mikeysklar/flatchord/cad/flatchord-button_thumb.stl

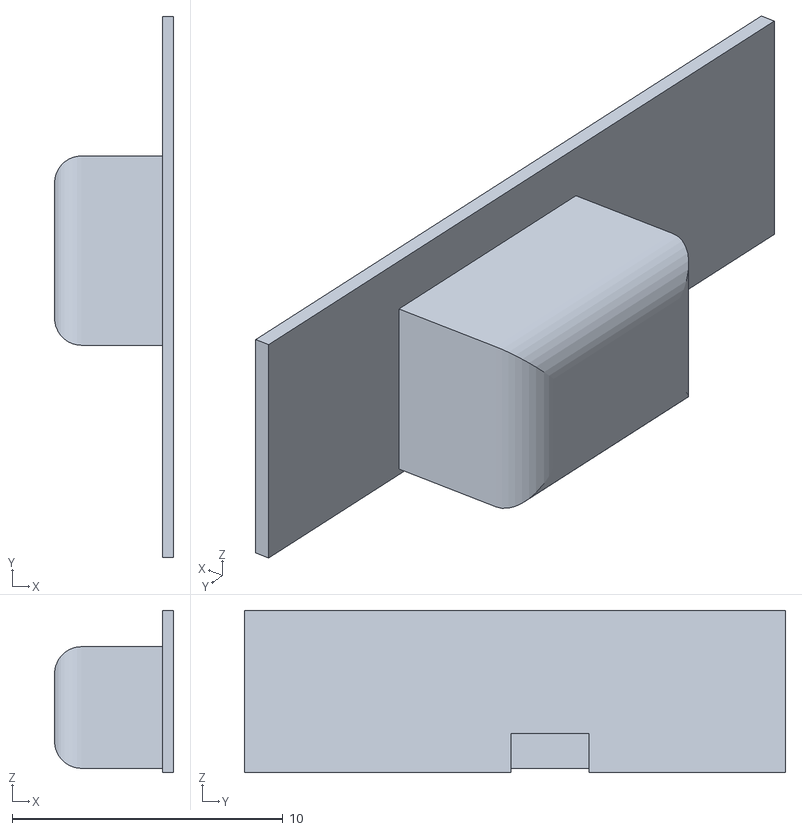
[picture p1: CAD file, 2025-08-23]
cad/flatchord-button_thumb.stl
4.40 x 20.0 x 6.00
