mikeysklar/flatchord/flatchord/flatchord.step

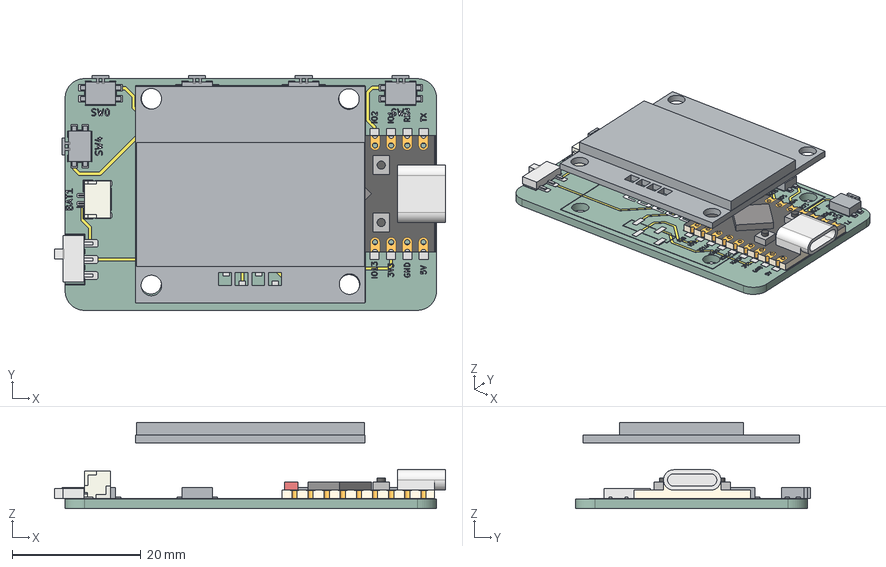
[picture p2: CAD file, 2025-08-22]
flatchord/flatchord.step
60.7 x 36.4 x 13.4 mm
ESP32S3 Super Mini
JST_GH_SM02B-GHS-TB_1x02-1MP_P1.25mm_Horizontal
flatchord_copper
flatchord_pad
flatchord_silkscreen
flatchord_PCB
