mikeysklar/flatchord/cad/flatchord.FCStd

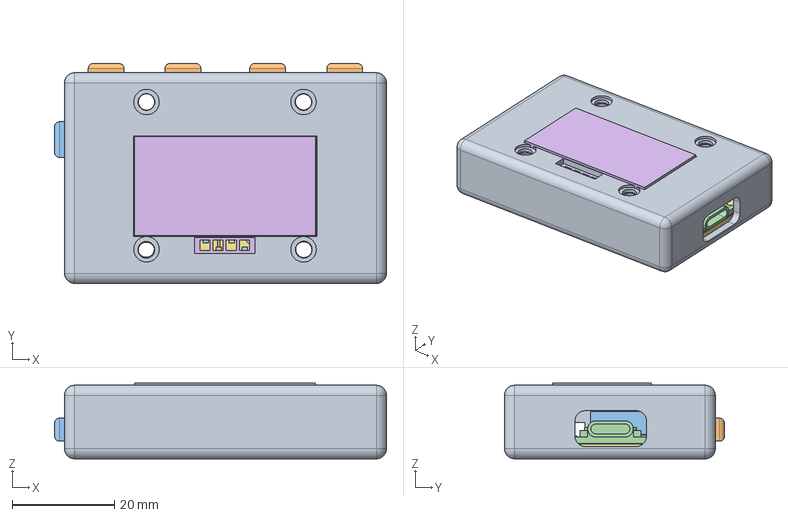
[picture p3: CAD file, 2025-08-23]
cad/flatchord.FCStd
64.9 x 43.0 x 14.8 mm
ESP32S3 Super Mini
JST_GH_SM02B-GHS-TB_1x02-1MP_P1.25mm_Horizontal
flatchord_copper
flatchord_copper001
flatchord_copper002
flatchord_copper003
flatchord_copper004
flatchord_copper005
flatchord_copper006
flatchord_copper007
flatchord_copper008
flatchord_copper009
flatchord_copper010
flatchord_pad
flatchord_pad001
flatchord_pad002
flatchord_pad003
flatchord_pad004
flatchord_pad005
flatchord_pad006
flatchord_pad007
flatchord_pad008
flatchord_pad009
flatchord_pad010
flatchord_pad011
flatchord_pad012
flatchord_pad013
flatchord_pad014
flatchord_pad015
flatchord_pad016
flatchord_pad017
flatchord_pad018
flatchord_pad019
flatchord_pad020
flatchord_pad021
flatchord_pad022
flatchord_pad023
flatchord_pad024
flatchord_pad025
flatchord_pad026
flatchord_pad027
flatchord_pad028
flatchord_pad029
flatchord_pad030
flatchord_pad031
flatchord_pad032
flatchord_pad033
flatchord_pad034
flatchord_pad035
flatchord_pad036
flatchord_pad037
flatchord_pad038
flatchord_pad039
flatchord_pad040
flatchord_pad041
flatchord_pad042
flatchord_pad043
flatchord_pad044
flatchord_pad045
flatchord_pad046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
