mikeysklar/flatchord/flatchord/flatchord-Edge_Cuts.dxf

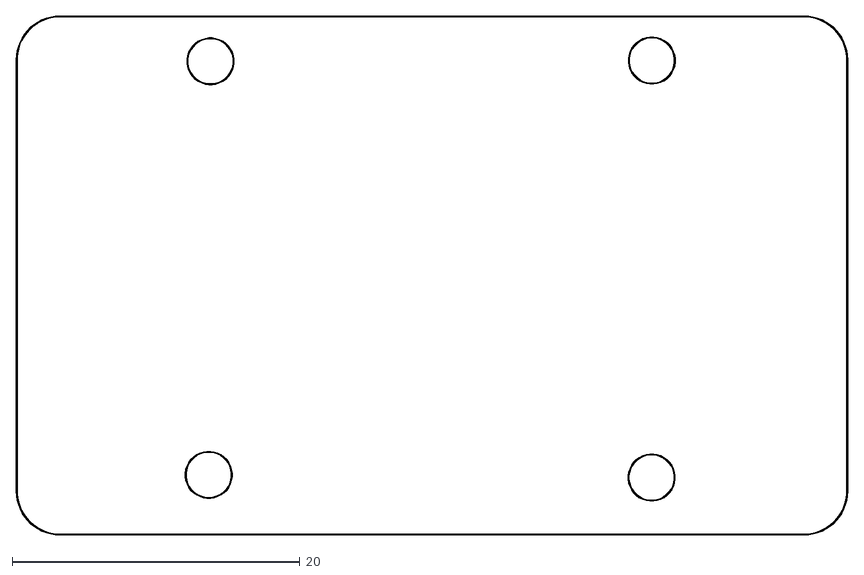
[picture p4: CAD file, 2025-08-20]
flatchord/flatchord-Edge_Cuts.dxf
57.7 x 36.0
