mikeysklar/flatchord/cad/flatchord-cap.stl

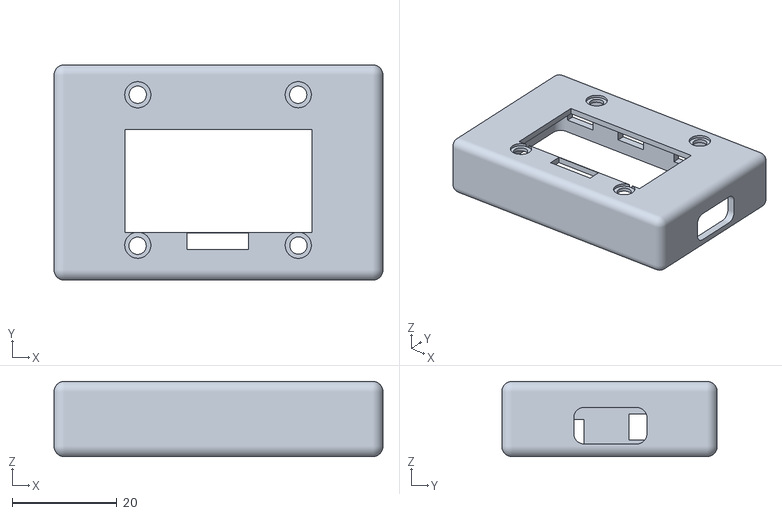
[picture p5: CAD file, 2025-08-23]
cad/flatchord-cap.stl
62.9 x 41.2 x 14.4
