mikeysklar/flatchord/flatchord/flatchord-F_Cu.dxf

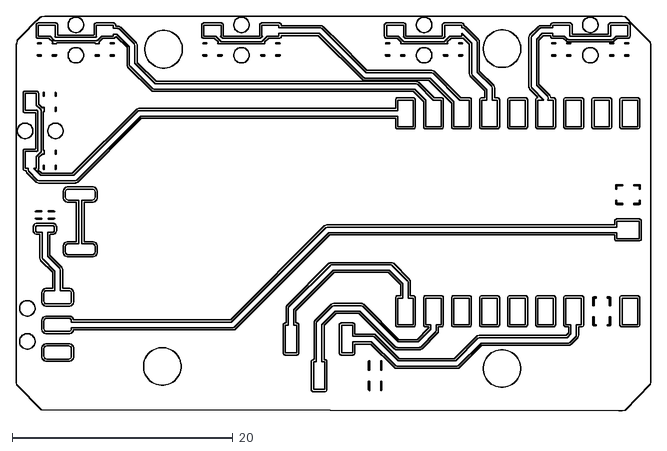
[picture p6: CAD file, 2025-08-20]
flatchord/flatchord-F_Cu.dxf
57.5 x 35.8
