mikeysklar/flatchord/cad/flatchord-base.stl

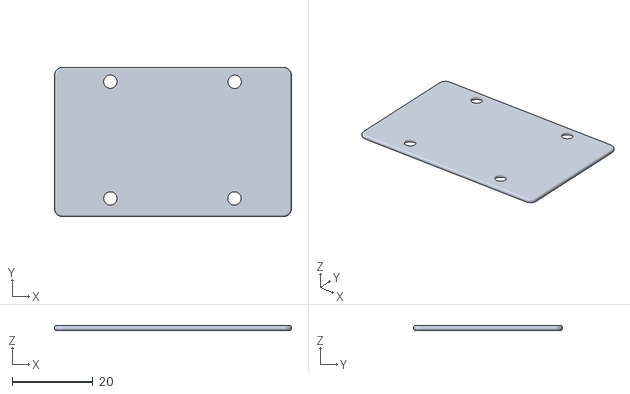
[picture p7: CAD file, 2025-08-20]
cad/flatchord-base.stl
58.6 x 36.9 x 1.20
