mikeysklar/flatchord/cad/flatchord-button_fingers.stl

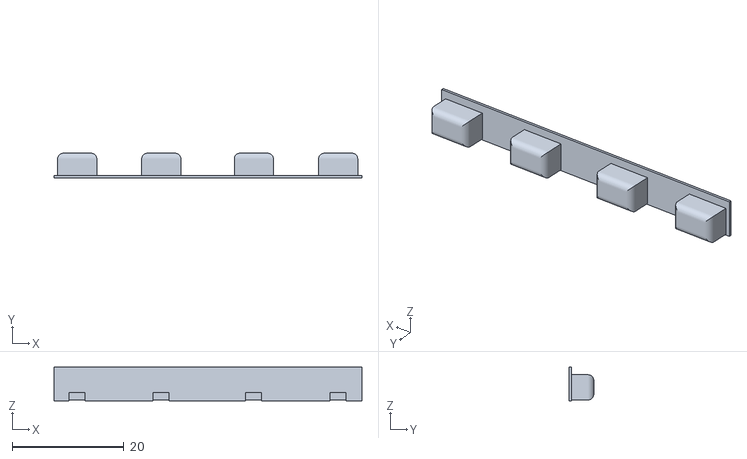
[picture p8: CAD file, 2025-08-20]
cad/flatchord-button_fingers.stl
55.0 x 4.40 x 6.00
