mikeysklar/flatchord/(list of files, cad)

Other CAD files:
flatchord/flatchord-B_Cu.dxf
flatchord/flatchord-B_Mask.dxf
flatchord/flatchord-B_Paste.dxf
flatchord/flatchord-B_Silkscreen.dxf
flatchord/flatchord-F_Mask.dxf
flatchord/flatchord-F_Paste.dxf
flatchord/flatchord-F_Silkscreen.dxf
