mikeysklar/flatchord/flatchord/flatchord.kicad_pcb

## KiCad design flatchord/flatchord.kicad_pcb (2025-08-22)

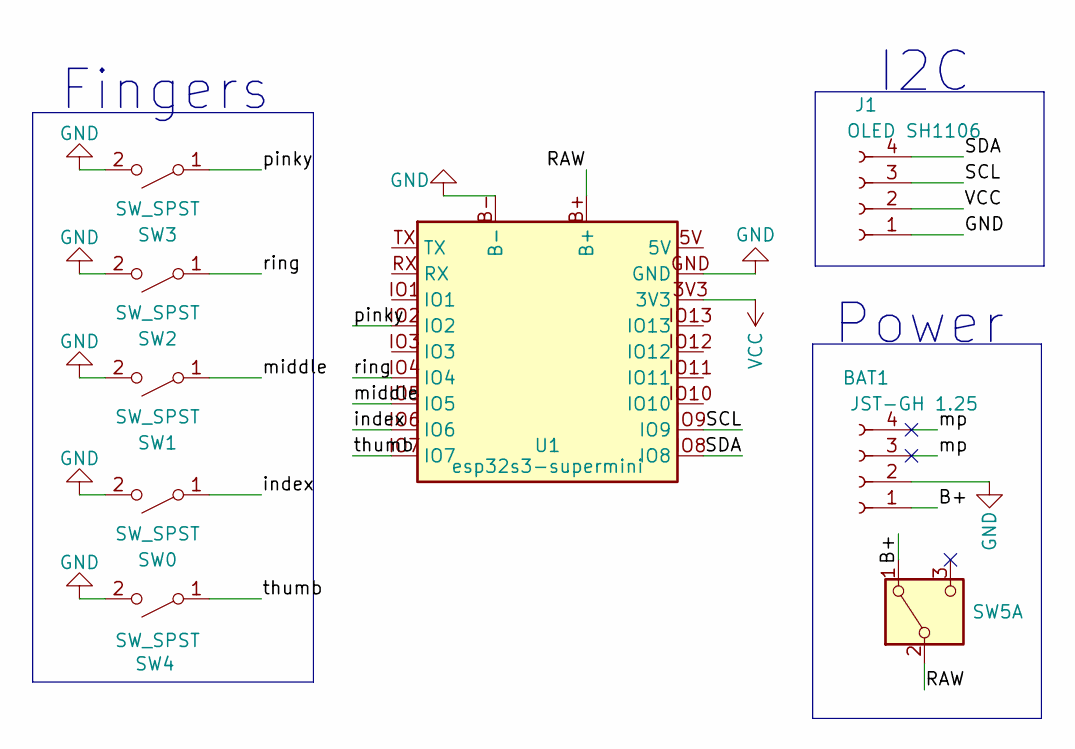
[picture p9: schematic flatchord.kicad_sch]

Parts:
BAT1: JST-GH 1.25; JST_GH_SM02B-GHS-TB_1x02-1MP_P1.25mm_Horizontal
J1: OLED SH1106; tft-sh1106-1.3-i2c
SW0, SW1, SW2, SW3, SW4: SW_SPST; Panasonic_EVQPUL_EVQPUC
SW5: SW_DPDT_x2; Untitled
U1: esp32s3-supermini; ESP32-S3-SuperMini_SMT

Connections:
/B+: BAT1.1, SW5.1 (A)
/RAW: SW5.2 (B), U1.B+
/SCL: J1.3, U1.IO9
/SDA: J1.4, U1.IO8
/index: SW0.1 (A), U1.IO6
/middle: SW1.1 (A), U1.IO5
/mp: BAT1.3, BAT1.4
/pinky: SW3.1 (A), U1.IO2
/ring: SW2.1 (A), U1.IO4
/thumb: SW4.1 (A), U1.IO7
GND: BAT1.2, J1.1, SW0.2 (B), SW1.2 (B), SW2.2 (B), SW3.2 (B), SW4.2 (B), U1.B-, U1.GND
VCC: J1.2, U1.3V3

Notes on the sheet:
Fingers
I2C
Power

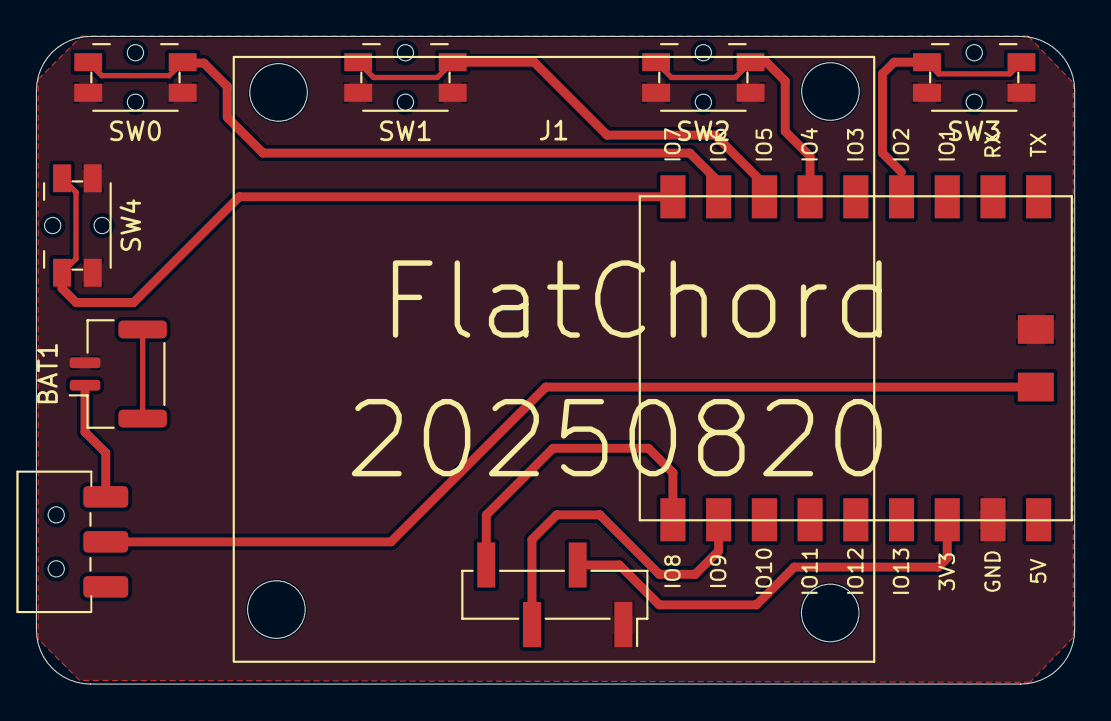
[picture p10: board flatchord.kicad_pcb from above]

Board: 2 copper layers, 57.7 x 36.0 mm, 9 parts (0 on the bottom side), 12 nets.
