mikeysklar/flatchord/src/flatchord.py

import time
import digitalio
import board
import busio
import displayio
from i2cdisplaybus import I2CDisplayBus
import adafruit_displayio_sh1106
import terminalio
from adafruit_display_text import label
import chords_config
import storage

time.sleep(0.1)

displayio.release_displays()

i2c = busio.I2C(scl=board.IO9, sda=board.IO8, frequency=400_000)
bus = I2CDisplayBus(i2c, device_address=0x3C, reset=None)

# SH1106 has 132x64 RAM; most 128x64 modules are shifted. Try colstart=2 (or 0/4 if needed).
display = adafruit_displayio_sh1106.SH1106(bus, width=128, height=64, colstart=2)
display.rotation = 180

display_group = displayio.Group(scale=1)
display.root_group = display_group

# Main text label 
text_buffer = ""
text_label = label.Label(
    terminalio.FONT, text=text_buffer, color=0xFFFFFF, x=0, y=15, scale=2
)
display_group.append(text_label)

SW_PINS = (
    board.IO6,  # SW0
    board.IO5,  # SW1
    board.IO4,  # SW2
    board.IO2,  # SW3
    board.IO7,  # SW4
)

pins = []
for gp in SW_PINS:
    p = digitalio.DigitalInOut(gp)
    p.direction = digitalio.Direction.INPUT
    p.pull = digitalio.Pull.UP
    pins.append(p)

# ─── USB HID setup (start OFF) ─────────────────────────────────────────
usbmode = False
keyboard = mouse = cc = None

def enable_hid():
    global usbmode, keyboard, mouse, cc, Keycode, ConsumerControlCode
    import usb_hid
    from adafruit_hid.keyboard import Keyboard
    from adafruit_hid.mouse import Mouse
    from adafruit_hid.consumer_control import ConsumerControl
    from adafruit_hid.consumer_control_code import ConsumerControlCode
    from adafruit_hid.keycode import Keycode
    keyboard = Keyboard(usb_hid.devices)
    mouse = Mouse(usb_hid.devices)
    cc = ConsumerControl(usb_hid.devices)
    usbmode = True
    print("USB HID enabled")

def disable_hid():
    global usbmode, keyboard, mouse, cc
    keyboard = mouse = cc = None
    usbmode = False
    print("USB HID disabled")

# ─── Timing constants ────────────────────────────────────────────────
STABLE_MS_ALPHA = 0.03
STABLE_MS_OTHER = 0.02
DEBOUNCE_UP      = 0.05
TAP_WINDOW       = 0.5
MIN_TAP_INT      = 0.1
L5_REPEAT_MS     = 0.1
NAV_REPEAT_MS    = 0.2
LAYER_LOCK_COOLDOWN = 0.1
SCROLL_REPEAT_MS  = 0.15
THUMB_HOLD_TO_LOCK = 0.12

# ─── State variables ────────────────────────────────────────────────
layer            = 1
thumb_taps       = 0
tap_in_prog      = False
last_tap_time    = 0.0
last_combo       = ()
pending_combo    = None
sent_release     = False
skip_scag        = False
scag_skip_combo  = None
modifier_armed   = False
held_modifier    = None
last_time        = time.monotonic()
held_combo       = ()
last_repeat      = 0.0
accel_active     = False
held_nav_combo   = ()
last_nav         = 0.0
last_pending_combo = None
last_layer_change = 0.0
held_scroll_combo = ()
last_scroll       = 0.0
last_thumb_rise    = 0.0
thumb_locked       = False
viewer_mode  = False
entries      = []
entry_idx    = 0
entry_offset = 0  # kept for future per-entry scrolling (10-char steps)
typing_offset = 0


# ─── Mouse chords for layer-7 ────────────────────────────────────────
MOVE_DELTA = 5
ACCEL_MULTIPLIER = 2
ACCEL_CHORD = (1, 2, 3)

# ─── edit view ──────────────────────────────────────────────
def render_typing_window():
    """Render the last 20 chars of text_buffer starting at typing_offset."""
    global text_buffer, text_label, typing_offset
    visible_window = 20
    # Clamp offset in case buffer shrank
    typing_offset = max(0, min(typing_offset, max(0, len(text_buffer) - visible_window)))
    start = typing_offset
    end   = typing_offset + visible_window
    window = text_buffer[start:end]
    # Pad to exactly 20 chars so both lines draw every time
    window = window + " " * (visible_window - len(window))
    text_label.text = window[:10] + "\n" + window[10:]

# ─── Save-to-file config ──────────────────────────────────────────────
SAVE_PATH = "/notes.txt"

def _insert_code():
    # Try to get Keycode.INSERT without requiring HID to be enabled
    try:
        from adafruit_hid.keycode import Keycode
        return Keycode.INSERT
    except Exception:
        # HID usage ID for Insert is 73
        return 73

INSERT_CODE = _insert_code()

# ─── Make FS writable if it’s read-only ──────────────────────────────
def ensure_writable():
    try:
        with open("/.__rw_test__", "w") as _t:
            _t.write("x")
        # cleanup
        try:
            import os
            os.remove("/.__rw_test__")
        except Exception:
            pass
        return True
    except OSError:
        # Attempt to remount read-write
        try:
            storage.remount("/", False)  # False => read-write
            return True
        except Exception as e:
            print("Remount failed:", e)
            return False

# ─── save ────────────────────────────────────────────
def save_entry():
    global text_buffer, text_label
    entry = text_buffer.rstrip("\n")
    path = "/notes.txt"

    # Ensure FS is writable; try once to fix if not
    if not ensure_writable():
        print("Save aborted: filesystem still read-only")
        return

    try:
        with open(path, "a") as f:
            if entry:
                f.write(entry + ",\n")   # <-- add comma + newline
            else:
                f.write(",\n")           # <-- blank entry still has comma
        try:
            storage.sync()
        except Exception:
            pass
        print(f"Saved {len(entry)} chars to {path}")
        # Clear buffer for the next entry
        text_buffer = ""
        text_label.text = text_buffer
    except OSError as e:
        print("Save failed:", e)

# ─── viewer mode ───────────────────────────────────────────────

def _kc(vname, fallback):
    try:
        from adafruit_hid.keycode import Keycode
        return getattr(Keycode, vname)
    except Exception:
        return fallback

KC_PAGE_UP   = _kc("PAGE_UP",   75)
KC_PAGE_DOWN = _kc("PAGE_DOWN", 78)
KC_UP        = _kc("UP_ARROW",  82)
KC_DOWN      = _kc("DOWN_ARROW",81)

def load_entries():
    """(Re)load entries from /notes.txt, ignoring blanks like ',\\n'."""
    global entries, entry_idx, entry_offset
    try:
        with open(SAVE_PATH, "r") as f:
            data = f.read().replace("\r\n", "\n")
    except OSError:
        entries = []
        entry_idx = 0
        entry_offset = 0
        return

    parts = data.split(",\n")
    if parts and parts[-1] == "":
        parts.pop()

    filtered = []
    for p in parts:
        if p.strip() == "":
            continue
        filtered.append(p.rstrip("\r\n"))

    entries = filtered
    entry_idx = 0 if entries else 0
    entry_offset = 0

def render_entry_window():
    """Show current entry in a fixed 2×10 window starting at entry_offset."""
    global text_label
    if not entries:
        text_label.text = "(no notes)"
        return
    s = entries[entry_idx]
    start = max(0, min(entry_offset, max(0, len(s) - 20)))
    window = s[start:start+20]
    window += " " * (20 - len(window))
    text_label.text = window[:10] + "\n" + window[10:]

def enter_viewer():
    """Clear screen, load entries, show first entry."""
    global viewer_mode, text_buffer
    text_buffer = ""           # clear typing buffer on entry
    text_label.text = ""       # clear screen immediately
    load_entries()
    viewer_mode = True
    render_entry_window()

def handle_page_nav(kc):
    """PAGE_UP/PAGE_DOWN with wrap-around between entries."""
    global entry_idx, entry_offset
    if not entries:
        render_entry_window()
        return
    if kc == KC_PAGE_UP:
        entry_idx = (entry_idx - 1) % len(entries)
    elif kc == KC_PAGE_DOWN:
        entry_idx = (entry_idx + 1) % len(entries)
    entry_offset = 0
    render_entry_window()

def handle_intra_scroll(kc):
    """Scroll inside the current entry by 10-char lines; clamp to bounds."""
    global entry_offset
    if not entries:
        render_entry_window()
        return
    s = entries[entry_idx]
    max_off = max(0, len(s) - 20)  # 2 lines × 10 chars visible = 20 window
    if kc == KC_UP:
        entry_offset = max(0, entry_offset - 10)
    elif kc == KC_DOWN:
        entry_offset = min(max_off, entry_offset + 10)
    render_entry_window()

# ─── Core chord logic ────────────────────────────────────────────────
def check_chords():
    global layer, thumb_taps, last_tap_time
    global last_combo, pending_combo, sent_release, skip_scag, scag_skip_combo
    global modifier_armed, held_modifier, last_time, last_repeat, accel_active
    global held_nav_combo, last_nav, held_combo, last_pending_combo
    global held_scroll_combo, last_scroll, text_buffer, text_label
    global usbmode, typing_offset

    now     = time.monotonic()
    pressed = tuple(not p.value for p in pins)
    combo   = tuple(i for i, down in enumerate(pressed) if down)

    # ─── A) Pure-thumb release ⇒ layer-lock ───────────────────────────
    if last_combo == (4,) and combo == ():
        if now - last_tap_time < TAP_WINDOW:
            thumb_taps += 1
        else:
            thumb_taps = 1
        last_tap_time = now
        layer = min(thumb_taps, 7)
        print(f"→ locked to layer-{layer}")
        pending_combo = None
        sent_release  = False
        skip_scag     = False
        modifier_armed = False
        held_modifier = None
        scag_skip_combo = None
        held_scroll_combo = ()
        last_combo = combo
        return

    # ─── B) Stabilize into pending_combo ──────────────────────────────
    if combo != last_combo:
        last_time = now
        if last_combo == () and combo != ():
            pending_combo = None
            sent_release  = False

    ms = STABLE_MS_ALPHA if layer == 1 else STABLE_MS_OTHER
    if combo and (now - last_time) >= ms and combo != pending_combo:
        pending_combo = combo

    pending_changed    = (pending_combo != last_pending_combo)
    last_pending_combo = pending_combo

    lm = chords_config.layer_maps[layer]

    # ─── Special: Layer‑3 chord (0,1,2,3,4) → toggle HID ──────────────
    if layer == 3 and combo == (0,1,2,3,4) and combo != last_combo:
        if not usbmode:
            enable_hid()
        else:
            disable_hid()
        text_label.text = "HID: ON" if usbmode else "HID: OFF"
        last_combo = combo
        sent_release = True
        time.sleep(0.3)  # debounce
        return

    # ─── macOS media keys ─────────────────────────────────────────────
    if usbmode and layer == 6:
        if combo and combo != last_combo and combo in lm:
            code = lm[combo]
            cc.send(code)
            sent_release = True
            time.sleep(DEBOUNCE_UP)

    # ─── Layer-4 SCAG “arm” ───────────────────────────────────────────
    if layer == 4 and not modifier_armed and pending_combo in chords_config.scag:
        held_modifier   = chords_config.scag[pending_combo]
        modifier_armed  = True
        scag_skip_combo = pending_combo
        skip_scag       = True
        pending_combo   = None
        last_combo      = ()
        return

    # ─── Layer-5: Mouse ───────────────────────────────────────────────
    if usbmode and layer == 5:
        accel_active = (pending_combo == chords_config.ACCEL_CHORD)

        if pending_combo in chords_config.mouse_button_chords and pending_changed:
            mouse.click(chords_config.mouse_button_chords[pending_combo])
            held_combo   = ()
            sent_release = True
            time.sleep(DEBOUNCE_UP)
            return

        if pending_combo in chords_config.mouse_scroll_chords and pending_changed:
            amt = chords_config.mouse_scroll_chords[pending_combo]
            if accel_active: amt *= ACCEL_MULTIPLIER
            mouse.move(wheel=amt)
            held_scroll_combo = pending_combo
            last_scroll       = now
            sent_release      = True
            return

        if (
            pending_combo == held_scroll_combo
            and pending_combo in chords_config.mouse_scroll_chords
            and (now - last_scroll) >= SCROLL_REPEAT_MS
        ):
            amt = chords_config.mouse_scroll_chords[pending_combo]
            if accel_active: amt *= ACCEL_MULTIPLIER
            mouse.move(wheel=amt)
            last_scroll = now
            return

        if pending_combo in chords_config.mouse_move_chords and pending_changed:
            dx, dy = chords_config.mouse_move_chords[pending_combo]
            if accel_active: dx *= ACCEL_MULTIPLIER; dy *= ACCEL_MULTIPLIER
            mouse.move(dx, dy)
            held_combo   = pending_combo
            last_repeat  = now
            sent_release = True
            return

        if pending_combo == held_combo \
           and pending_combo in chords_config.mouse_move_chords \
           and (now - last_repeat) >= L5_REPEAT_MS:
            dx, dy = chords_config.mouse_move_chords[held_combo]
            if accel_active: dx *= ACCEL_MULTIPLIER; dy *= ACCEL_MULTIPLIER
            mouse.move(dx, dy)
            last_repeat = now
            return

        if pending_combo in chords_config.mouse_hold_chords and pending_changed:
            mouse.press(chords_config.mouse_hold_chords[pending_combo])
            held_combo   = ()
            sent_release = True
            return

        if pending_combo in chords_config.mouse_release_chords and pending_changed:
            mouse.release(chords_config.mouse_release_chords[pending_combo])
            held_combo   = ()
            sent_release = True
            return

    # ─── First-release send for layers 1–3,6-7 ───────────────────────
    if len(combo) < len(last_combo) and last_combo and not sent_release:
        if skip_scag and last_combo == scag_skip_combo:
            skip_scag = False
        else:
            use = pending_combo or last_combo
            if layer == 4 and modifier_armed and last_combo in chords_config.alpha and usbmode:
                key = chords_config.alpha[last_combo]
                keyboard.press(held_modifier, key)
                keyboard.release_all()
                layer           = 1
                thumb_taps      = 1
                modifier_armed  = False
                skip_scag       = False

            elif layer in (1, 2, 3, 6, 7):
                # Skip HID toggle chord (layer‑3, (0,1,2,3,4))
                if use != (4,) and not (layer == 3 and use == (0,1,2,3,4)):
                    kc = lm.get(use)
                    if kc:
                        if usbmode:
                            keyboard.press(kc)
                            keyboard.release_all()

                        if kc == 61:  # handled above
                            pass
                        # ── Backspace Logic ─────────────────────
                        elif kc == 42:  # Backspace
                            if text_buffer:
                                text_buffer = text_buffer[:-1]
                                # If we deleted back past the current window, pull it up by one line
                                if typing_offset > 0 and len(text_buffer) <= typing_offset:
                                    typing_offset = max(0, typing_offset - 10)
                            render_typing_window()
                        # ── Save on INSERT ─────────────────────
                        elif kc == INSERT_CODE:
                            save_entry()
                            # Optional: brief debounce so you don't double-save
                            time.sleep(0.15)
                        # ── VIEW: enter + wrap-around paging ─────────
                        elif kc in (KC_PAGE_UP, KC_PAGE_DOWN):
                            if not viewer_mode:
                                enter_viewer()          # clears screen, loads first entry
                            else:
                                handle_page_nav(kc)     # wrap-around prev/next
                            # (Optional) small debounce
                            time.sleep(0.12)
                        # ── VIEW: intra-entry scroll (UP/DOWN) ───────
                        elif kc in (KC_UP, KC_DOWN):
                            if not viewer_mode:
                                enter_viewer()
                            handle_intra_scroll(kc)
                            time.sleep(0.08)

                        else:
                            # 1. Map kc -> printable char
                            if 4 <= kc <= 29:        # A-Z
                                char = chr(kc - 4 + ord('a'))
                            elif 30 <= kc <= 38:     # 1-9
                                char = chr(kc - 30 + ord('1'))
                            elif kc == 39:           # 0
                                char = "0"
                            elif kc == 44:           # Space
                                char = " "
                            else:
                                char = "?"           # <-- here

                            # 2. Append the character
                            text_buffer += char

                            # 3. If we overflow the 2×10 window, scroll down one line (10 chars)
                            if len(text_buffer) > typing_offset + 20:
                                typing_offset += 10

                            # 4. Render the current typing window
                            render_typing_window()

        sent_release = True
        time.sleep(DEBOUNCE_UP)

    if not combo and last_combo:
        pending_combo  = None
        sent_release   = False
        held_nav_combo = ()
        skip_layer_lock = False

    last_combo = combo

# ─── Main loop ───────────────────────────────────────────────────────
while True:
    check_chords()
    time.sleep(0.01)
