mikeysklar/flatchord/(commit log)

2025-08-03 sch done / pcb started
    [flatchord.kicad_pcb, flatchord.kicad_sch]
2025-08-04 named board
    [flatchord-B_Cu.dxf, flatchord-B_Mask.dxf, flatchord-B_Paste.dxf, flatchord-B_Silkscreen.dxf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]
2025-08-07 working PCB
    making the case
    [flatchord-B_Cu.dxf, flatchord-B_Mask.dxf, flatchord-B_Paste.dxf, flatchord-B_Silkscreen.dxf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]
2025-08-07 case structure up
    very organized spreadsheet with comments.
    [flatchord.kicad_pcb]
2025-08-08 first case draft done
    [flatchord-base.stl, flatchord-cap.stl]
2025-08-10 2nd case print
    Good fit and works. Minor adjustments added to tighten up button fit. There is a slight wiggle.
    [flatchord-base.stl, flatchord-button_fingers.stl, flatchord-button_thumb.stl, flatchord-cap.stl, flatchord.FCStd]
2025-08-17 switch to esp32-s3 supermini
    [flatchord.FCStd]
2025-08-19 significant changes
    new display 1.3" SH1106 and ESP32-S3 supermini, big shrink in size
    [flatchord-B_Cu.dxf, flatchord-B_Mask.dxf, flatchord-B_Paste.dxf, flatchord-B_Silkscreen.dxf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]
2025-08-20 getting small
    [flatchord.FCStd, flatchord.kicad_pcb, flatchord.step]
2025-08-20 ready for prototypes
    [flatchord-Edge_Cuts.dxf, flatchord-F_Cu.dxf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]
2025-08-20 ready to fab
    [flatchord-B_Cu.gbr, flatchord-B_Mask.gbr, flatchord-B_Paste.gbr, flatchord-B_Silkscreen.gbr, flatchord-Edge_Cuts.gbr, flatchord-F_Cu.gbr, flatchord-F_Mask.gbr, flatchord-F_Paste.gbr]
2025-08-22 taller not smaller
    needed to really boost the height based on pre-soldered male header on TFT. keeps it all SMT otherwise. Board passes all basic checks (charge, keys, tft) chord code needs work to display chars.
    [flatchord-cap.stl, flatchord.FCStd, flatchord.kicad_pcb, flatchord.step]
2025-08-23 flipped display works
    180 rotation
    [flatchord.py]
2025-08-23 case mods for better fit
    new big pink thumb
    [flatchord-button_thumb.stl, flatchord-cap.stl, flatchord.FCStd]
